DrNotThatEvil/neflow/code/TODO.md

# 2023-10-30: Editing and View menu flow done.
Added the editing flow some bugs still remain but it's verry nice (if i do say so myself)
i also reworked the button events so you can have it repeat which is so much nicer for editing the values.

Next thing will be saving and loading the profile from flash storage
after you should probably finish the pcb design, while you wait on the order you can cleanup the menu code.

By the way when designing the pcb please take some measurements of the toaster oven you ordered
it's gonna need to fit in it. 

But as of now even tho the menu code can do with some housekeeping, i'm really happy with how
this is turning out so far, it's still a lot of stuff to do on the code (temp control and reflow etc)
but it's fun getting to play with the breadboard and designing the pcb along side it.

# 2023-10-27: Basic menu flow design and implementation
Added the basic menu system, please see drawio diagrams for flow.
Added basic profiles (no flash yet but thats gonna go after editing and saving)

# 2024-12-10: Reworked the tempsys and added formating.
Reworked the tempsys, reworked and refactored a lot of code (this branch was main branch for way to long)
Added a .clang-format file to just stick to a format it's not perfect but i will get used to it i guess.
On the note of refacoring, i know it's not the most 'clean'? but i'm happy with the stucture rework
there is still some work to do on readability but it's this can be done more piece meal i think.

Also if some folks read this due to showing this thing off at the tinker-dag, HI!
Don't judge to harshly and if you do then I would love to know how you get the time to do
super clean hobby projects xD only joking would love any feedback!

# TODO:
* ~~Add the editing flow for the profile~~ (2023-10-30: DONE!)
* ~~Add loading the profiles from flash storage.~~ (????-??-??: Done!)
* Restructure the nf_menu.c functions to reduce the duplicate code.
* ~~Add 'confirm screen' after the 'Run' menu option to make sure it's not being called on accident (use different button maybe?)~~
* ~~Temprature system still only supports one temprature probe and currently its a duplicated line to get the temprature which is ugly, both should be fixed.~~ (2024-12-05: Kind of done...)
* ~~The second sensor temprature can now be sent to the UI thread but it has not been implementend in the PID loop, this should not be hard to do but still needs to be done.~~ (2024-12-10: Done!, BUT STILL UNTESTED need second probe!)
* ~~Check if other parts of the code still have a hardcoded temprature probe.~~ (2024-12-10: Done!)
* Test with a second temprature probe, and test second probe port with only one probe to see if sensor selection works well.
* Add second temprature to display
* Show current temprature mode on display and avg if using 2 probes.
* Currently PCB has fan ports but the codebase does not use em, implement these in the future
* ~~The 'confirm screen' needs some more info before starting it's somewhat barebones.~~
* The 'graph' has no temprature target lines, also the current temp is not displayed in text maybe implement a text version that gets shown when holding a button?
* ~~The 'finished' screen needs confirmation on opening the door and a BEEEEP.~~

# Refactor  
* The modules have a lot of crossing dependencies needs to be fixed.
* some headers have weird names nf_config.h for example has the system state? after cleanup
this can be fixed to a better name i think.

# Bugs
The first time can go negative while editing? Do idea why but if you don't do that it's fine to tired to figure it out now.
