DrNotThatEvil/neflow/pcb/neflow.kicad_pcb

## KiCad design pcb/neflow.kicad_pcb (2024-12-22)

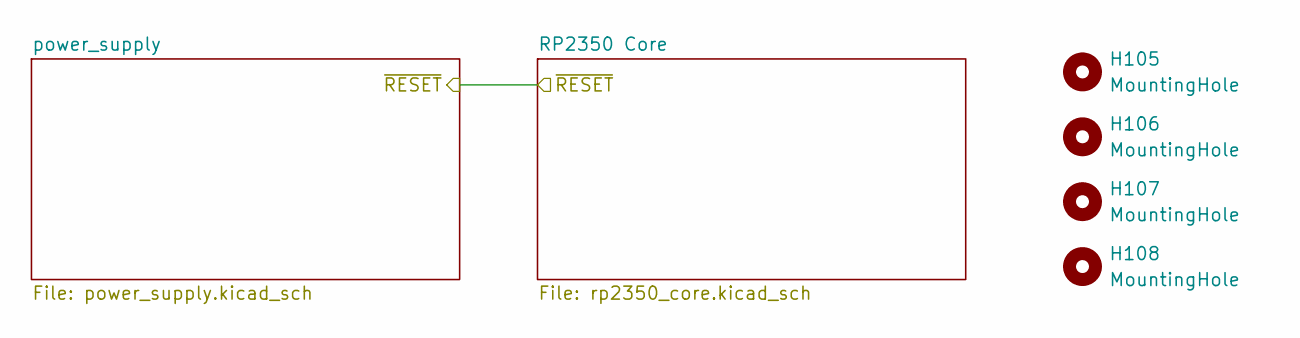
[picture p1: schematic neflow.kicad_sch]

Parts:
H105, H106, H107, H108: MountingHole; MountingHole_3mm

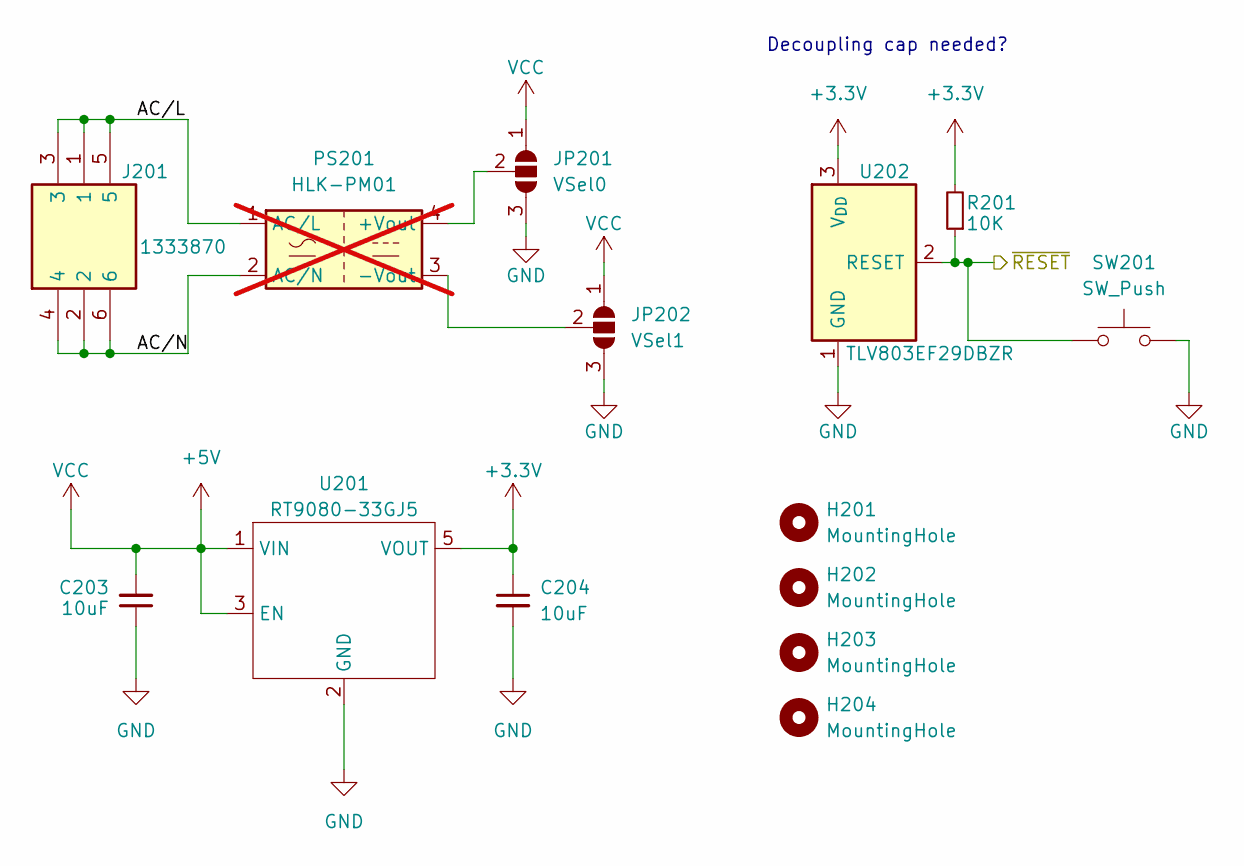
[picture p2: schematic power_supply.kicad_sch]

Parts:
C203, C204: 10uF; R_0603_1608Metric; LCSC C19702
H201, H202, H203, H204: MountingHole; MountingHole_3mm
J201: 1333870; Manufacturer_Part_Number 1333870; Mouser Part Number 651-1333870
JP201: VSel0; SolderJumper-3_P1.3mm_Open_Pad1.0x1.5mm
JP202: VSel1; SolderJumper-3_P1.3mm_Open_Pad1.0x1.5mm
PS201: HLK-PM01; Converter_ACDC_HiLink_HLK-PMxx; not fitted
R201: 10K; R_0603_1608Metric; LCSC C25804
SW201: SW_Push; BUTTON_SILICON
U201: RT9080-33GJ5; TSOT-23-5
U202: TLV803EF29DBZR; SOT-23; LCSC C2868252

Connections:
+3.3V: C204.1, R201.2, U201.5 (VOUT), U202.3 (V_{DD}); also elsewhere on the board
+5V: C203.2, JP201.1 (A), JP202.1 (A), U201.1 (VIN), U201.3 (EN); also elsewhere on the board
/power_supply/AC/L: J201.1, J201.3, J201.5, PS201.1 (AC/L)
/power_supply/AC/N: J201.2, J201.4, J201.6, PS201.2 (AC/N)
/power_supply/~RESET: R201.1, SW201.2, U202.2 (RESET)
GND: C203.1, C204.2, JP201.3 (B), JP202.3 (B), SW201.1, U201.2 (GND), U202.1 (GND); also elsewhere on the board
unnamed: JP201.2 (C), PS201.4 (+Vout)
unnamed: JP202.2 (C), PS201.3 (-Vout)

Notes on the sheet:
Decoupling cap needed?

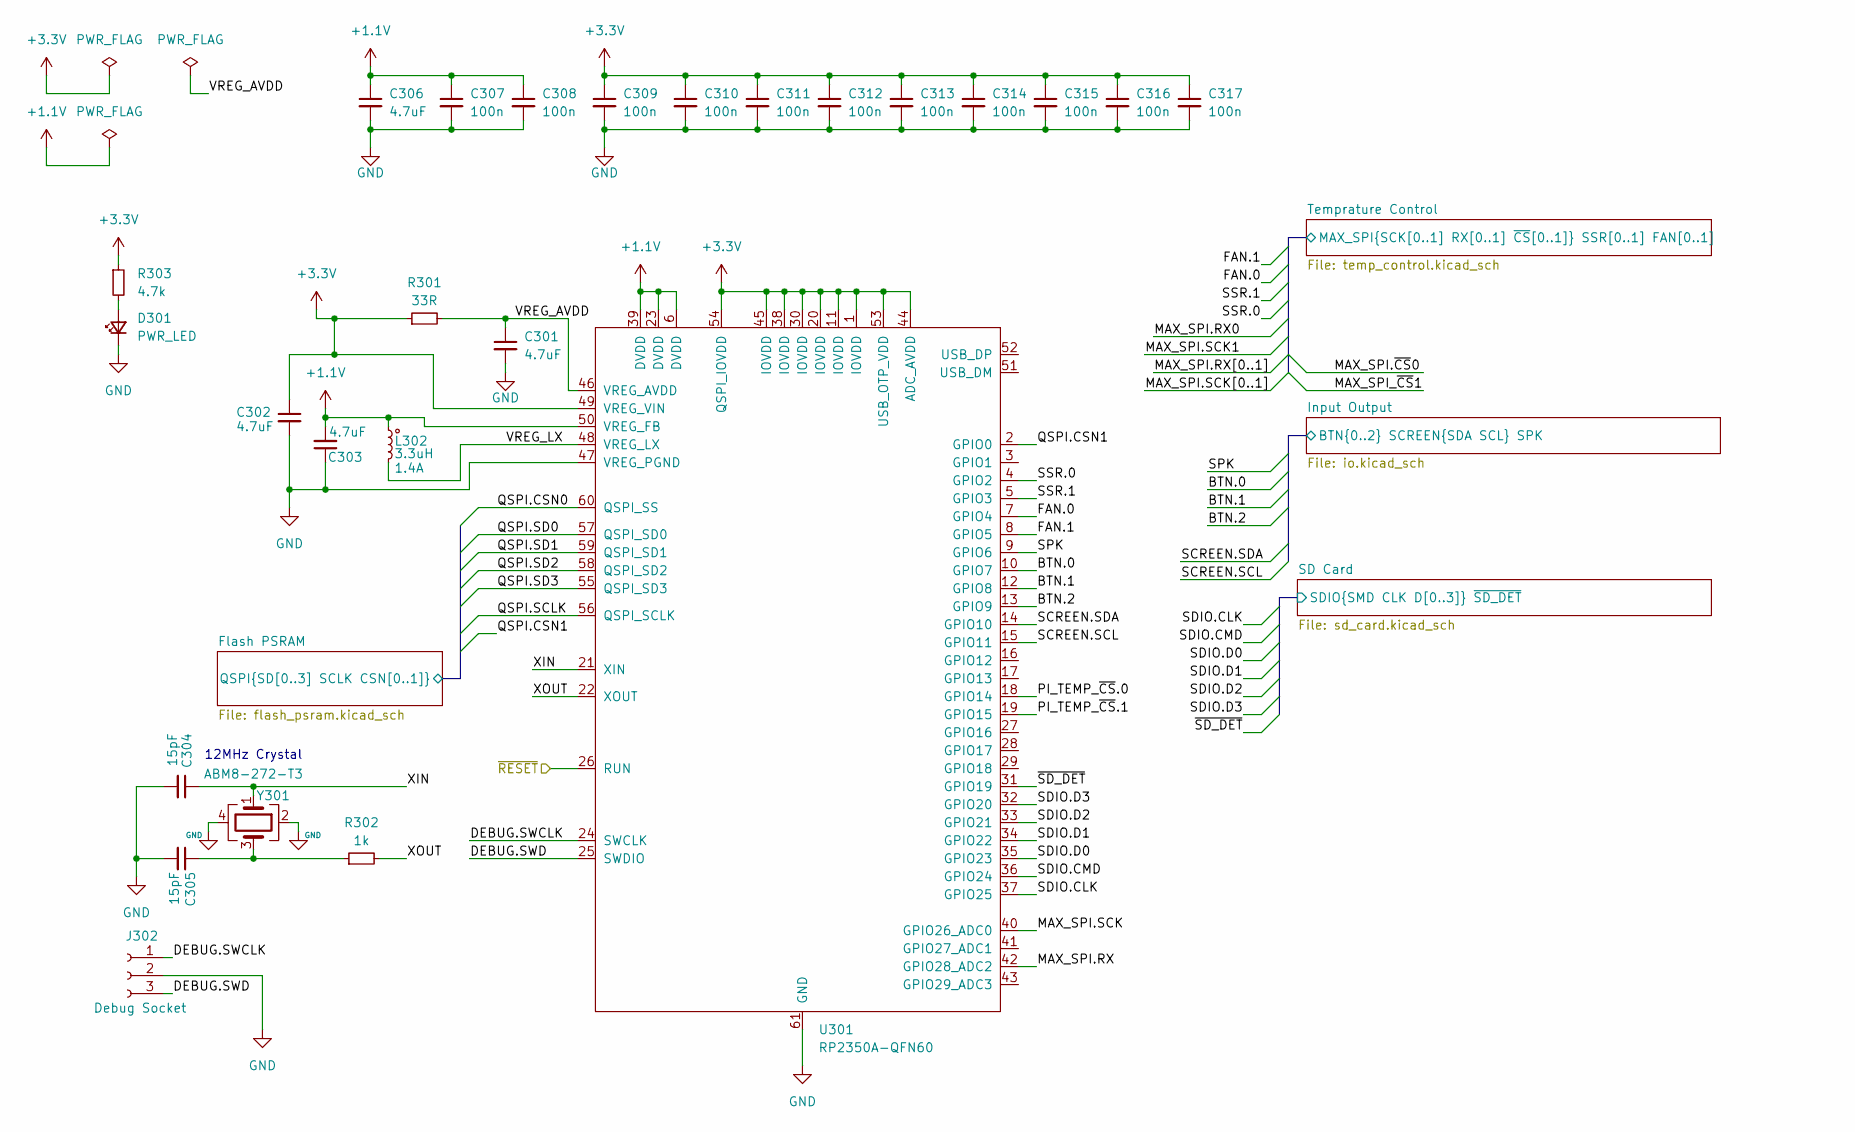
[picture p3: schematic rp2350_core.kicad_sch]

Parts:
C301, C302, C303, C306: 4.7uF; R_0603_1608Metric
C304, C305: 15pF; R_0603_1608Metric
C307, C308, C309, C310, C311, C312, C313, C314, C315, C316, C317: 100n; R_0603_1608Metric
D301: PWR_LED; LED_0805_2012Metric
J302: Debug Socket; JST_XH_B3B-XH-AM_1x03_P2.50mm_Vertical
L302: 3.3uH; 0806_Polarized
R301: 33R; R_0603_1608Metric
R302: 1k; R_0603_1608Metric
R303: 4.7k; R_0603_1608Metric
U301: RP2350A-QFN60; QFN-60-1EP_7x7mm_P0.4mm_EP3.4x3.4mm_ThermalVias
Y301: ABM8-272-T3; Crystal_SMD_3.2x2.5mm

Connections:
+1.1V: C303.2, C306.1, C307.1, C308.1, L302.1, U301.6 (DVDD), U301.23 (DVDD), U301.39 (DVDD), U301.50 (VREG_FB)
+3.3V: C302.1, C309.1, C310.1, C311.1, C312.1, C313.1, C314.1, C315.1, C316.1, C317.1, R301.1, R303.1, U301.1 (IOVDD), U301.11 (IOVDD), U301.20 (IOVDD), U301.30 (IOVDD), U301.38 (IOVDD), U301.44 (ADC_AVDD), U301.45 (IOVDD), U301.49 (VREG_VIN), U301.53 (USB_OTP_VDD), U301.54 (QSPI_IOVDD); also elsewhere on the board
/RP2350 Core/BTN.0: U301.10 (GPIO7)
/RP2350 Core/BTN.1: U301.12 (GPIO8)
/RP2350 Core/BTN.2: U301.13 (GPIO9)
/RP2350 Core/DEBUG.SWCLK: J302.1, U301.24 (SWCLK)
/RP2350 Core/DEBUG.SWD: J302.3, U301.25 (SWDIO)
/RP2350 Core/FAN.0: U301.7 (GPIO4)
/RP2350 Core/FAN.1: U301.8 (GPIO5)
/RP2350 Core/Flash PSRAM/QSPI.CSN0: U301.60 (QSPI_SS); also elsewhere on the board
/RP2350 Core/Flash PSRAM/QSPI.CSN1: U301.2 (GPIO0); also elsewhere on the board
/RP2350 Core/Flash PSRAM/QSPI.SCLK: U301.56 (QSPI_SCLK); also elsewhere on the board
/RP2350 Core/Flash PSRAM/QSPI.SD0: U301.57 (QSPI_SD0); also elsewhere on the board
/RP2350 Core/Flash PSRAM/QSPI.SD1: U301.59 (QSPI_SD1); also elsewhere on the board
/RP2350 Core/Flash PSRAM/QSPI.SD2: U301.58 (QSPI_SD2); also elsewhere on the board
/RP2350 Core/Flash PSRAM/QSPI.SD3: U301.55 (QSPI_SD3); also elsewhere on the board
/RP2350 Core/PI_TEMP_~CS.0: U301.18 (GPIO14)
/RP2350 Core/PI_TEMP_~CS.1: U301.19 (GPIO15)
/RP2350 Core/SCREEN.SCL: U301.15 (GPIO11)
/RP2350 Core/SCREEN.SDA: U301.14 (GPIO10)
/RP2350 Core/SD Card/SDIO.CLK: U301.37 (GPIO25); also elsewhere on the board
/RP2350 Core/SD Card/SDIO.D0: U301.35 (GPIO23); also elsewhere on the board
/RP2350 Core/SD Card/SDIO.D1: U301.34 (GPIO22); also elsewhere on the board
/RP2350 Core/SD Card/SDIO.D2: U301.33 (GPIO21); also elsewhere on the board
/RP2350 Core/SD Card/SDIO.D3: U301.32 (GPIO20); also elsewhere on the board
/RP2350 Core/SDIO.CMD: U301.36 (GPIO24)
/RP2350 Core/SPK: U301.9 (GPIO6)
/RP2350 Core/SSR.0: U301.4 (GPIO2)
/RP2350 Core/SSR.1: U301.5 (GPIO3)
/RP2350 Core/Temprature Control/MAX_SPI.RX: U301.16 (GPIO12); also elsewhere on the board
/RP2350 Core/Temprature Control/MAX_SPI.SCK: U301.17 (GPIO13); also elsewhere on the board
/RP2350 Core/VREG_AVDD: C301.1, R301.2, U301.46 (VREG_AVDD)
/RP2350 Core/VREG_LX: L302.2, U301.48 (VREG_LX)
/RP2350 Core/XIN: C304.1, U301.21 (XIN), Y301.1
/RP2350 Core/XOUT: R302.2, U301.22 (XOUT)
/RP2350 Core/~RESET: U301.26 (RUN)
/RP2350 Core/~SD_DET: U301.31 (GPIO19)
GND: C301.2, C302.2, C303.1, C304.2, C305.2, C306.2, C307.2, C308.2, C309.2, C310.2, C311.2, C312.2, C313.2, C314.2, C315.2, C316.2, C317.2, D301.1 (K), J302.2, U301.47 (VREG_PGND), U301.61 (GND), Y301.2, Y301.4; also elsewhere on the board
unnamed: C305.1, R302.1, Y301.3
unnamed: D301.2 (A), R303.2

Notes on the sheet:
12MHz Crystal

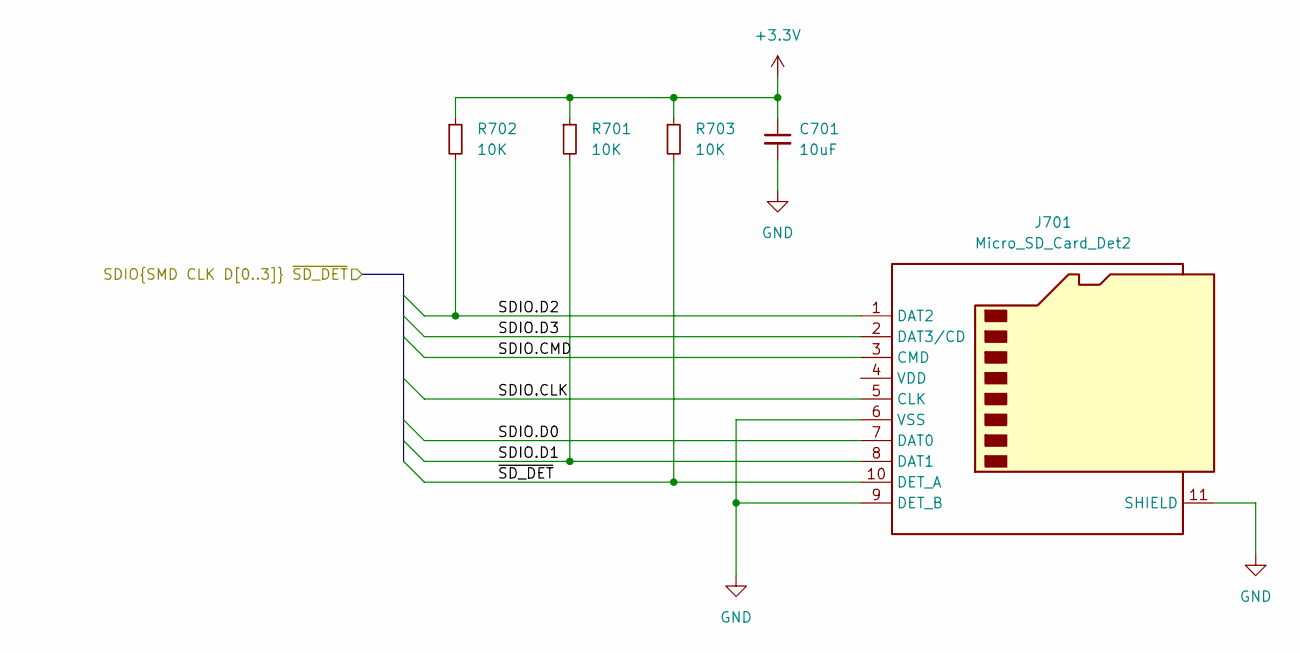
[picture p4: schematic sd_card.kicad_sch]

Parts:
C701: 10uF; R_0603_1608Metric
J701: Micro_SD_Card_Det2; microSD_HC_Hirose_DM3AT-SF-PEJM5
R701, R702, R703: 10K; R_0603_1608Metric

Connections:
+3.3V: C701.1, R701.1, R702.1, R703.1; also elsewhere on the board
/RP2350 Core/SD Card/SDIO.CLK: J701.5 (CLK); also elsewhere on the board
/RP2350 Core/SD Card/SDIO.CMD: J701.3 (CMD)
/RP2350 Core/SD Card/SDIO.D0: J701.7 (DAT0); also elsewhere on the board
/RP2350 Core/SD Card/SDIO.D1: J701.8 (DAT1), R701.2; also elsewhere on the board
/RP2350 Core/SD Card/SDIO.D2: J701.1 (DAT2), R702.2; also elsewhere on the board
/RP2350 Core/SD Card/SDIO.D3: J701.2 (DAT3/CD); also elsewhere on the board
/RP2350 Core/SD Card/~SD_DET: J701.10 (DET_A), R703.2
GND: C701.2, J701.6 (VSS), J701.9 (DET_B), J701.11 (SHIELD); also elsewhere on the board

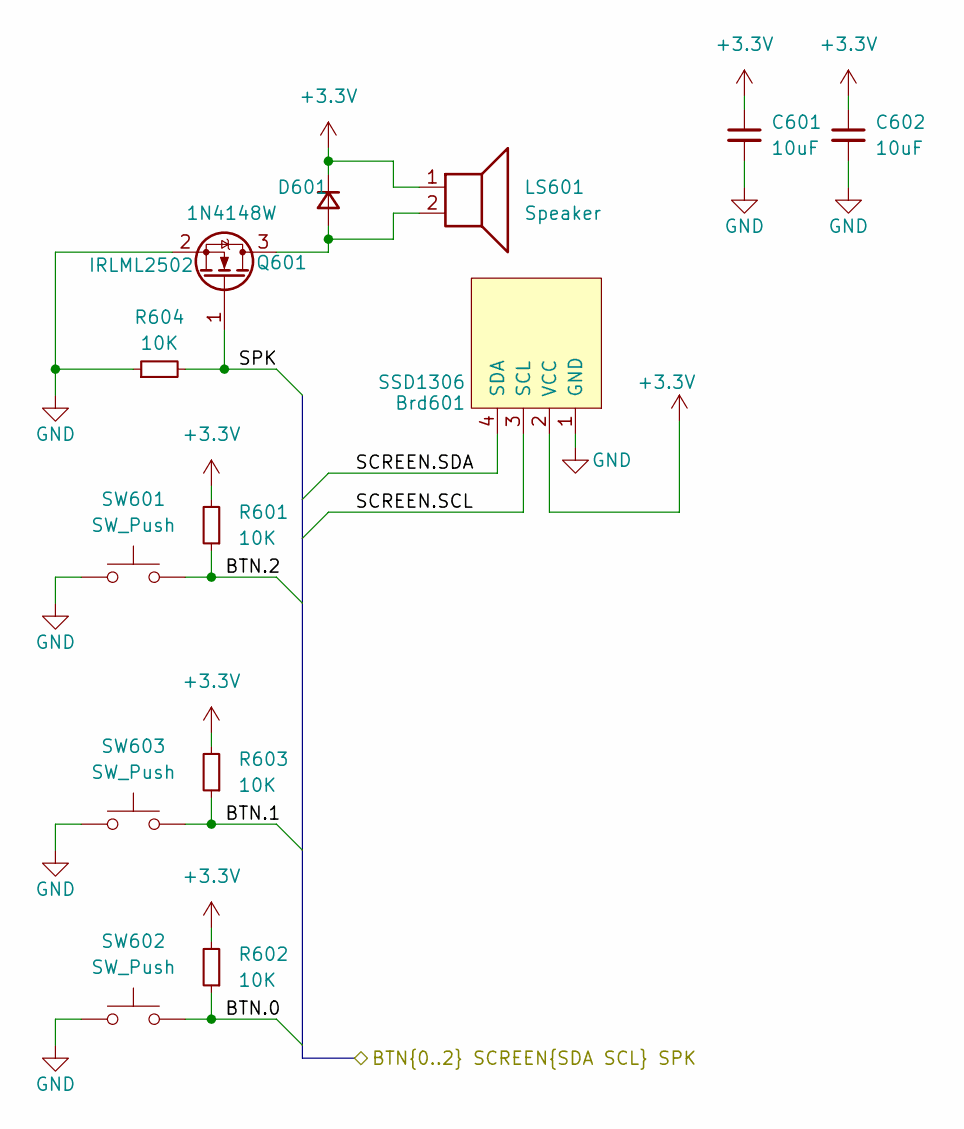
[picture p5: schematic io.kicad_sch]

Parts:
Brd601: SSD1306; 128x64OLED
C601, C602: 10uF; R_0603_1608Metric; LCSC C19702
D601: 1N4148W; D_SOD-123; LCSC C81598
LS601: Speaker; PassiveBuzzerSMD_JiangsuHuaneng_MLT-5030
Q601: IRLML2502; SOT-23; LCSC C2589
R601, R602, R603, R604: 10K; R_0603_1608Metric; LCSC C25804
SW601, SW602, SW603: SW_Push; BUTTON_SILICON

Connections:
+3.3V: Brd601.2 (VCC), C601.1, C602.1, D601.1 (K), LS601.1, R601.2, R602.2, R603.2; also elsewhere on the board
/RP2350 Core/Input Output/BTN.0: R602.1, SW602.2
/RP2350 Core/Input Output/BTN.1: R603.1, SW603.2
/RP2350 Core/Input Output/BTN.2: R601.1, SW601.2
/RP2350 Core/Input Output/SCREEN.SCL: Brd601.3 (SCL)
/RP2350 Core/Input Output/SCREEN.SDA: Brd601.4 (SDA)
/RP2350 Core/Input Output/SPK: Q601.1 (G), R604.2
GND: Brd601.1 (GND), C601.2, C602.2, Q601.2 (S), R604.1, SW601.1, SW602.1, SW603.1; also elsewhere on the board
unnamed: D601.2 (A), LS601.2, Q601.3 (D)

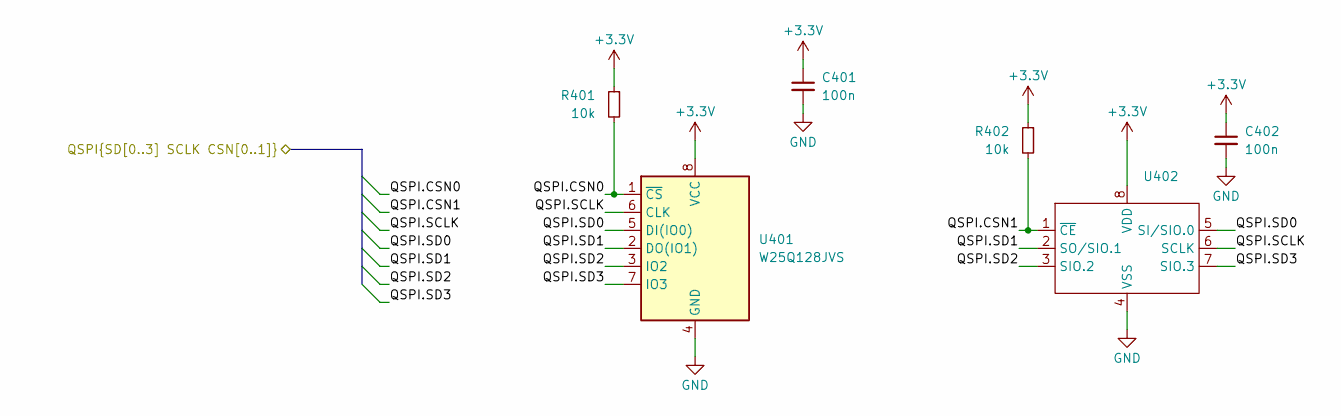
[picture p6: schematic flash_psram.kicad_sch]

Parts:
C401, C402: 100n; R_0603_1608Metric
R401, R402: 10k; R_0603_1608Metric
U401: W25Q128JVS; SOIC-8_5.23x5.23mm_P1.27mm
U402: SOIC-8_3.9x4.9mm_P1.27mm

Connections:
+3.3V: C401.1, C402.1, R401.1, R402.1, U401.8 (VCC), U402.8 (VDD); also elsewhere on the board
/RP2350 Core/Flash PSRAM/QSPI.CSN0: R401.2, U401.1 (~CS); also elsewhere on the board
/RP2350 Core/Flash PSRAM/QSPI.CSN1: R402.2, U402.1 (~CE); also elsewhere on the board
/RP2350 Core/Flash PSRAM/QSPI.SCLK: U401.6 (CLK), U402.6 (SCLK); also elsewhere on the board
/RP2350 Core/Flash PSRAM/QSPI.SD0: U401.5 (DI(IO0)), U402.5 (SI/SIO.0); also elsewhere on the board
/RP2350 Core/Flash PSRAM/QSPI.SD1: U401.2 (DO(IO1)), U402.2 (SO/SIO.1); also elsewhere on the board
/RP2350 Core/Flash PSRAM/QSPI.SD2: U401.3 (IO2), U402.3 (SIO.2); also elsewhere on the board
/RP2350 Core/Flash PSRAM/QSPI.SD3: U401.7 (IO3), U402.7 (SIO.3); also elsewhere on the board
GND: C401.2, C402.2, U401.4 (GND), U402.4 (VSS); also elsewhere on the board

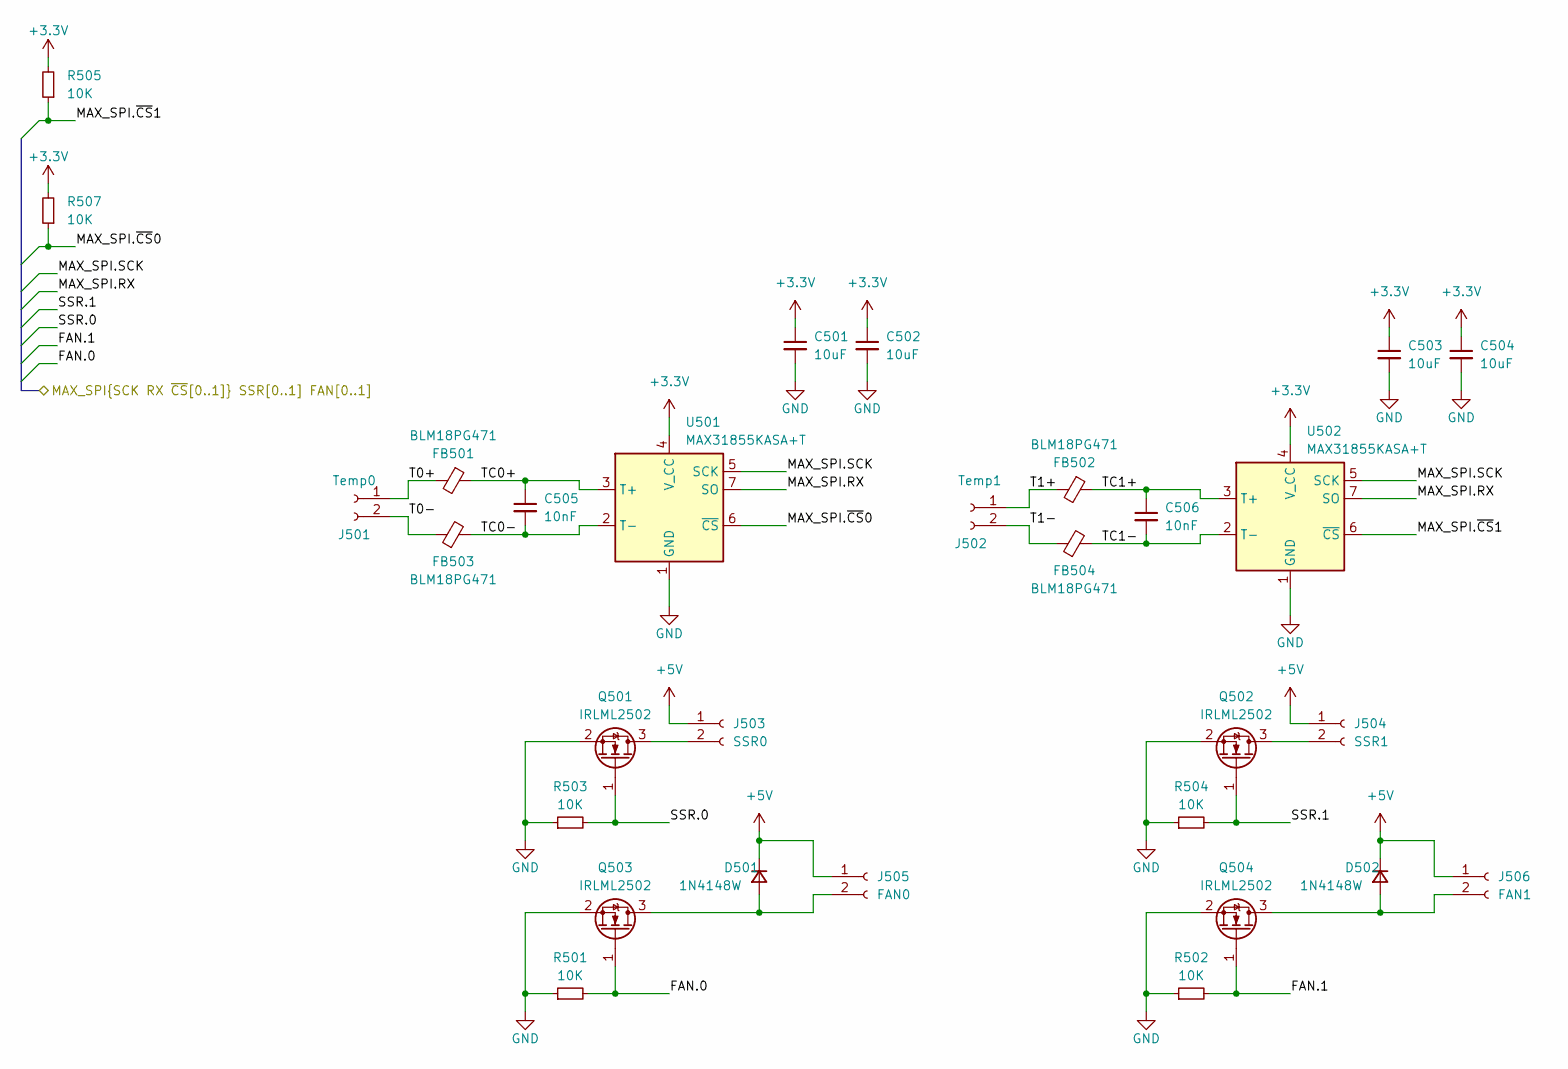
[picture p7: schematic temp_control.kicad_sch]

Parts:
C501, C502, C503, C504: 10uF; R_0603_1608Metric; LCSC C19702
C505, C506: 10nF; R_0603_1608Metric; LCSC C57112
D501, D502: 1N4148W; D_SOD-123; LCSC C81598
FB501, FB502, FB503, FB504: BLM18PG471; R_0603_1608Metric; LCSC C97853
J501: Temp0; JST_XH_B2B-XH-AM_1x02_P2.50mm_Vertical
J502: Temp1; JST_XH_B2B-XH-AM_1x02_P2.50mm_Vertical
J503: SSR0; JST_XH_B2B-XH-AM_1x02_P2.50mm_Vertical
J504: SSR1; JST_XH_B2B-XH-AM_1x02_P2.50mm_Vertical
J505: FAN0; JST_XH_B2B-XH-AM_1x02_P2.50mm_Vertical
J506: FAN1; JST_XH_B2B-XH-AM_1x02_P2.50mm_Vertical
Q501, Q502, Q503, Q504: IRLML2502; SOT-23; LCSC C2589
R501, R502, R503, R504, R505, R507: 10K; R_0603_1608Metric; LCSC C25804
U501, U502: MAX31855KASA+T; SOIC-8_3.9x4.9mm_P1.27mm; LCSC C52028

Connections:
+3.3V: C501.1, C502.1, C503.1, C504.1, R505.2, R507.2, U501.4 (V_CC), U502.4 (V_CC); also elsewhere on the board
+5V: D501.1 (K), D502.1 (K), J503.1, J504.1, J505.1, J506.1; also elsewhere on the board
/RP2350 Core/Temprature Control/FAN.0: Q503.1 (G), R501.2
/RP2350 Core/Temprature Control/FAN.1: Q504.1 (G), R502.2
/RP2350 Core/Temprature Control/MAX_SPI.RX: U501.7 (SO), U502.7 (SO); also elsewhere on the board
/RP2350 Core/Temprature Control/MAX_SPI.SCK: U501.5 (SCK), U502.5 (SCK); also elsewhere on the board
/RP2350 Core/Temprature Control/PI_TEMP_~CS.0: R507.1, U501.6 (~CS)
/RP2350 Core/Temprature Control/PI_TEMP_~CS.1: R505.1, U502.6 (~CS)
/RP2350 Core/Temprature Control/SSR.0: Q501.1 (G), R503.2
/RP2350 Core/Temprature Control/SSR.1: Q502.1 (G), R504.2
/RP2350 Core/Temprature Control/T0+: FB501.2, J501.1
/RP2350 Core/Temprature Control/T0-: FB503.1, J501.2
/RP2350 Core/Temprature Control/T1+: FB502.2, J502.1
/RP2350 Core/Temprature Control/T1-: FB504.1, J502.2
/RP2350 Core/Temprature Control/TC0+: C505.1, FB501.1, U501.3 (T+)
/RP2350 Core/Temprature Control/TC0-: C505.2, FB503.2, U501.2 (T-)
/RP2350 Core/Temprature Control/TC1+: C506.1, FB502.1, U502.3 (T+)
/RP2350 Core/Temprature Control/TC1-: C506.2, FB504.2, U502.2 (T-)
GND: C501.2, C502.2, C503.2, C504.2, Q501.2 (S), Q502.2 (S), Q503.2 (S), Q504.2 (S), R501.1, R502.1, R503.1, R504.1, U501.1 (GND), U502.1 (GND); also elsewhere on the board
unnamed: D501.2 (A), J505.2, Q503.3 (D)
unnamed: D502.2 (A), J506.2, Q504.3 (D)
unnamed: J503.2, Q501.3 (D)
unnamed: J504.2, Q502.3 (D)

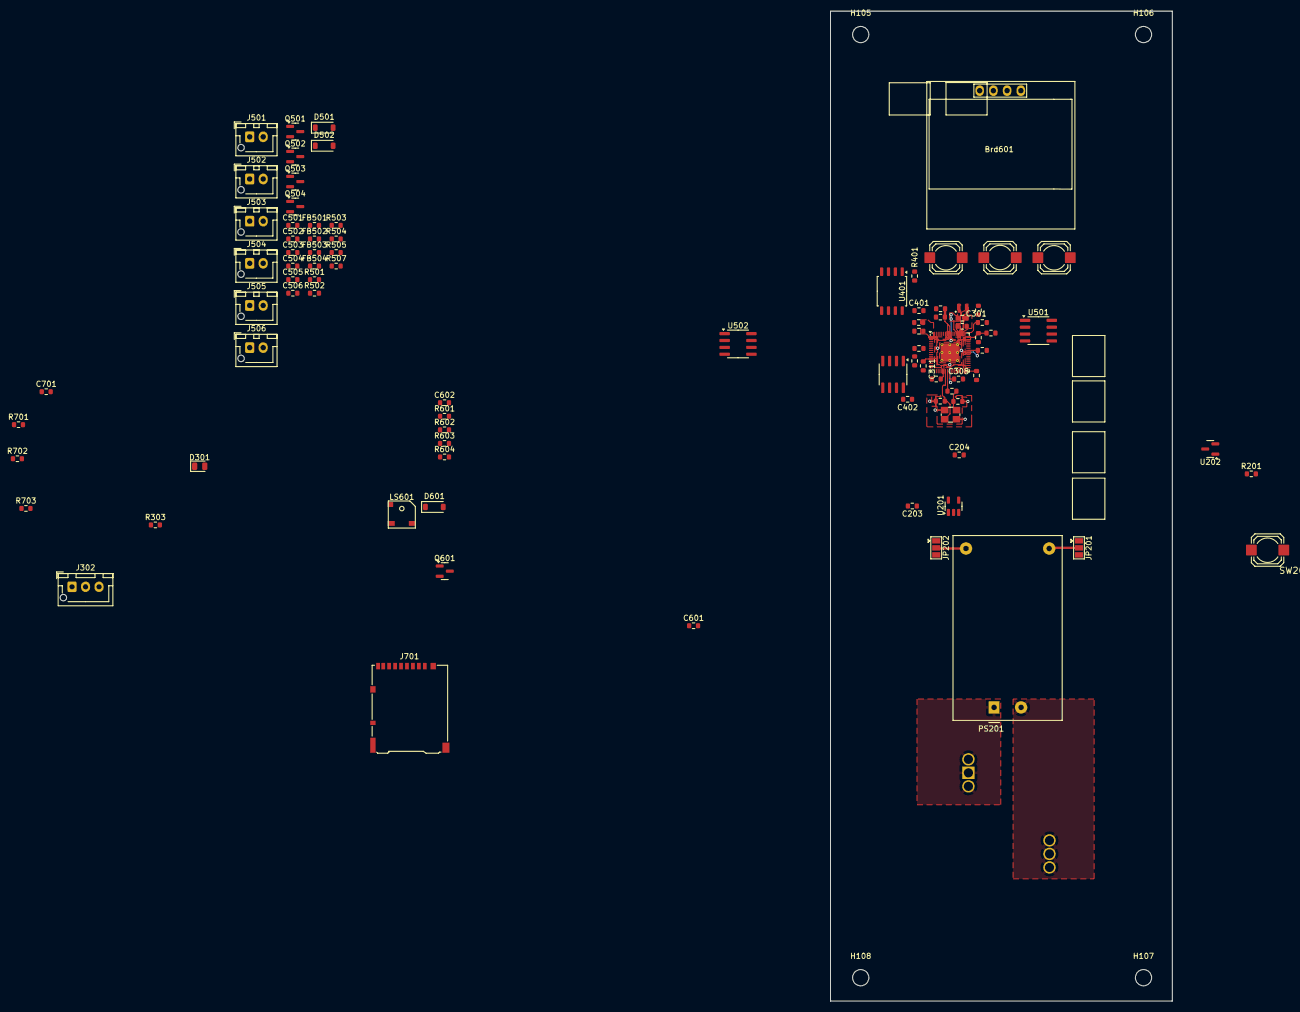
[picture p8: board neflow.kicad_pcb from above]

Board: 4 copper layers, 63.2 x 183.1 mm, 97 parts (1 on the bottom side), 55 nets.
