DrNotThatEvil/neflow/code/include/nf_memory.h

#ifndef NF_MEMORY_H
#define NF_MEMORY_H

#include "nf_common.h"
#include <hardware/flash.h>
#include <hardware/sync.h>
#include <pico/multicore.h>
#include <string.h>

#define FLASH_TARGET_OFFSET (PICO_FLASH_SIZE_BYTES - FLASH_SECTOR_SIZE)
#define PID_KP_INDEX        0
#define PID_KI_INDEX        1
#define PID_KD_INDEX        2

#define NF_MEMORY_PREFIX_BYTE 0xB9

typedef void (*MemorySaveCallback)(void *ptr);

typedef struct nf_memory
{
    float pid_data[2][3];
    uint profile_data[NUMBER_OF_PROFILES][PROFILE_TARGETS_SIZE][2];
} _nf_memory_t;

typedef struct nf_memory_state
{
    bool was_saved;
    int empty_page_index;
    _nf_memory_t *current_buffer;
} _nf_memory_state_t;

void nf_memory_init(_nf_memory_state_t *_memory);
void nf_memory_get_first_empty_page(_nf_memory_state_t *_memory);
void nf_initalize_empty(_nf_memory_state_t *_memory);

void nf_memory_clear(_nf_memory_state_t *_memory);
bool nf_memory_load_page(_nf_memory_state_t *_memory, uint page);
bool nf_memory_load_last_page(_nf_memory_state_t *_memory);

void nf_memory_save(_nf_memory_state_t *_memory);
void nf_memory_save_with_callback(_nf_memory_state_t *_memory,
                                  MemorySaveCallback cb, void *ptr);

#endif
