DrNotThatEvil/neflow/code/src/debounce.c

#include "debounce.h"

static volatile absolute_time_t dbounce_timeouts[NGPIO] = {0u};

bool debounce(uint gpio)
{
    if (get_absolute_time() < dbounce_timeouts[(gpio % NGPIO)])
    {
        return true;
    }

    dbounce_timeouts[(gpio % NGPIO)] = make_timeout_time_ms(DEBOUNCE_MS);
    return false;
}
