DrNotThatEvil/neflow/(commit log)

2023-10-22 WIP: Adding empty pcb project
    [neflow.kicad_pcb, neflow.kicad_sch]
2023-10-22 WIP: Schematic rev0 almost done
    [neflow.kicad_sch]
2023-10-23 WIP: Adding button footprint
    [neflow.kicad_sch]
2023-10-29 WIP: Switching to laptop
2023-10-30 WIP: Edit and view profile flow added
2024-12-10 Feature/code refactor (#1)
    * Starting to split screens in appropriate sections and files
    * Pushing notes
    * WIP: switching to laptop
    * Basic new flow for cleanup structure
    * Add silicone_btn and pcb
    * WIP: Finished new profiles menu
    * WIP: Adding new edit screen base
    * WIP: additing value edit arrows
    * WIP: Editing value
    * WIP: added back button to the new edit screen
    * Adding almost finished schematic
    * Added power to pico
    * WIP: Switching to workstation
    * WIP: Working on pcb
    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
    [neflow.kicad_pcb, neflow.kicad_sch]
2024-12-16 Reworking to rp2350 intergrated
    [flash_psram.kicad_sch, io.kicad_sch, neflow.kicad_sch, power_supply.kicad_sch, rp2350_core.kicad_sch, sd_card.kicad_sch, temp_control.kicad_sch]
2024-12-22 WIP: Stashing work to mess with vm
    [neflow.kicad_pcb, power_supply.kicad_sch, rp2350_core.kicad_sch, temp_control.kicad_sch]
